michalnand/motoko_ice_dragon_x/README.md

# motoko ice dragon X 
