michalnand/motoko_ice_dragon_x/cut/outline.png

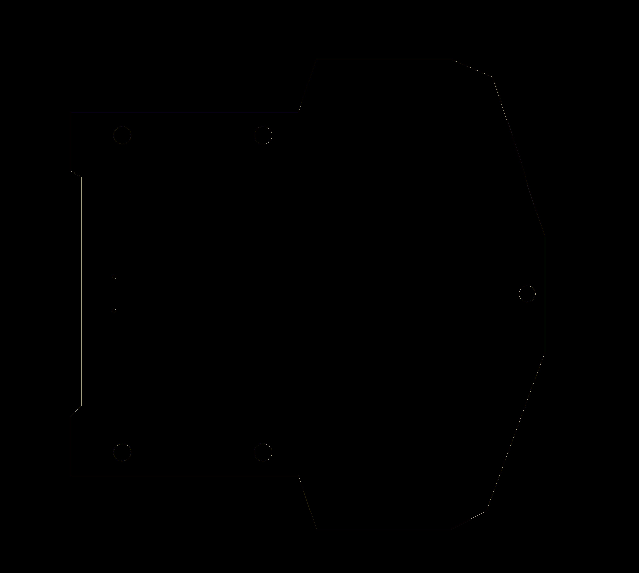
cut/outline.png
