michalnand/motoko_ice_dragon_x/cut/profile.png

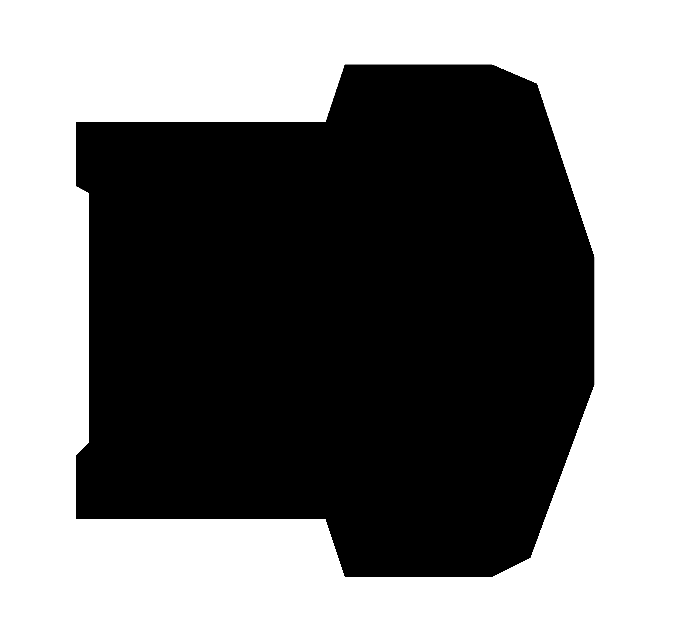
cut/profile.png
