michalnand/motoko_ice_dragon_x/doc/diagrams/control-motor_control.png

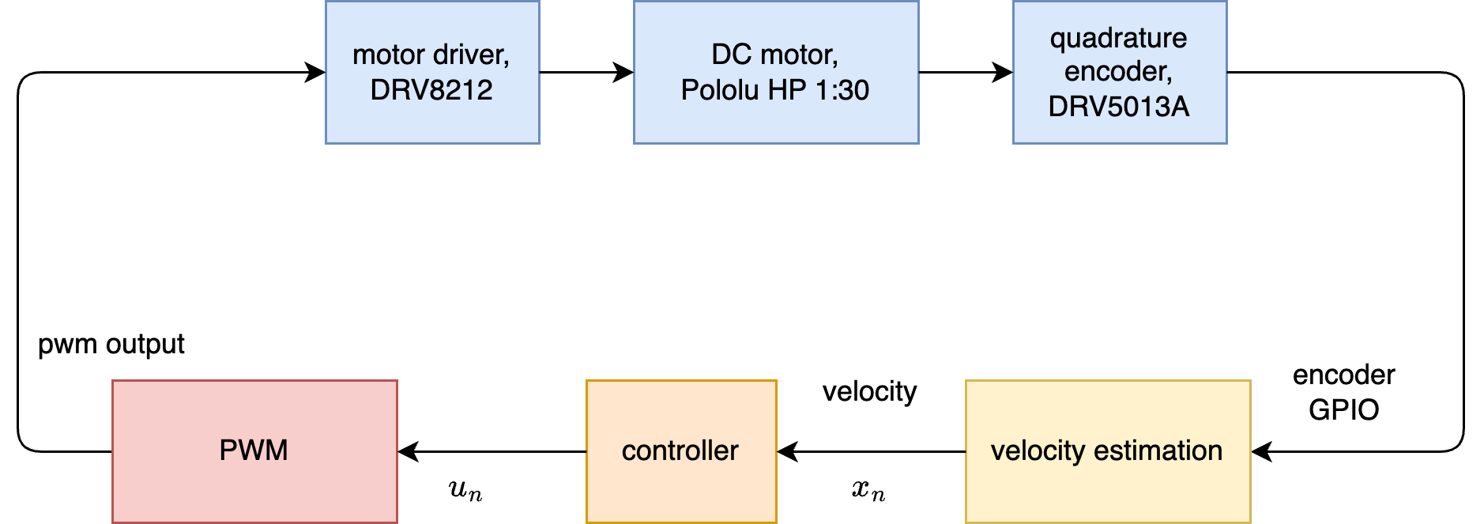
doc/diagrams/control-motor_control.png
