michalnand/motoko_ice_dragon_x/doc/diagrams/controller.png

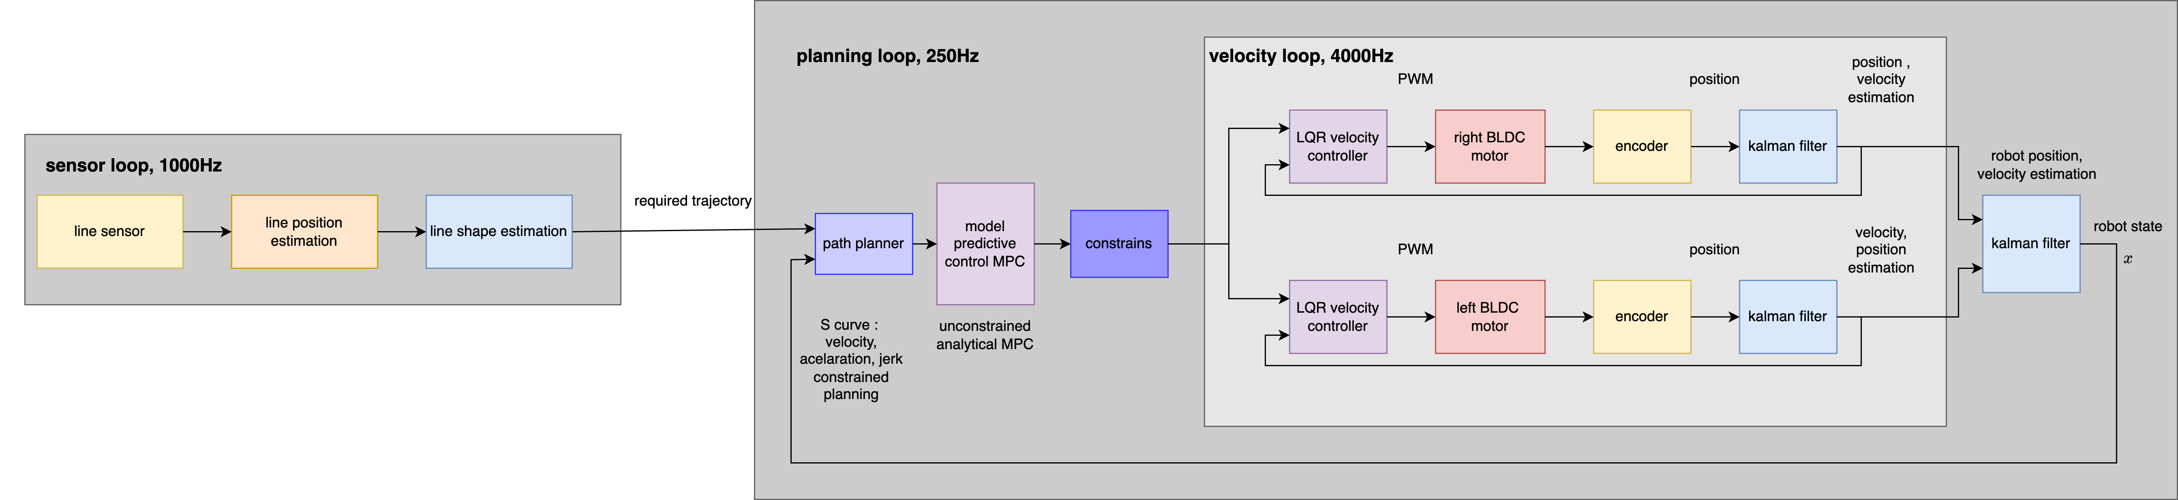
doc/diagrams/controller.png
