michalnand/motoko_ice_dragon_x/doc/images/board_dims_b.png

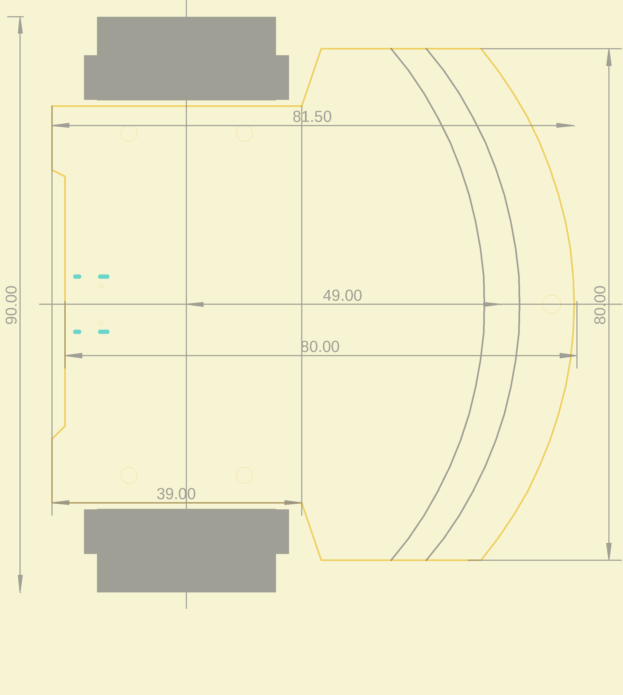
doc/images/board_dims_b.png
