michalnand/motoko_ice_dragon_x/doc/images/board_dims_c.png

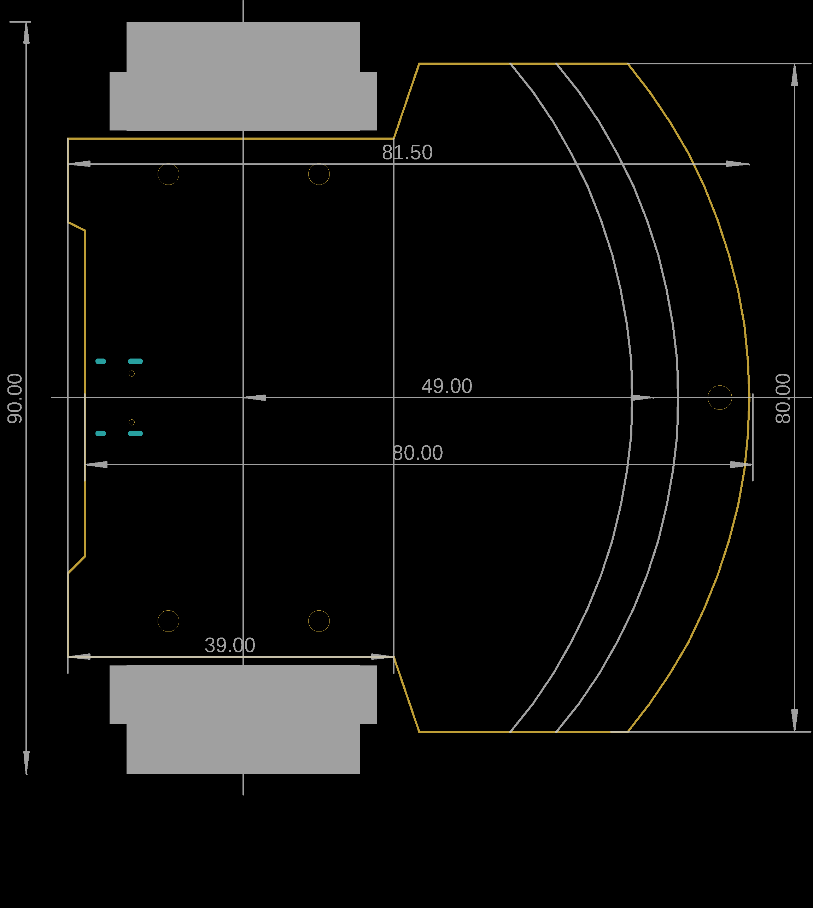
doc/images/board_dims_c.png
