michalnand/motoko_ice_dragon_x/doc/images/box.png

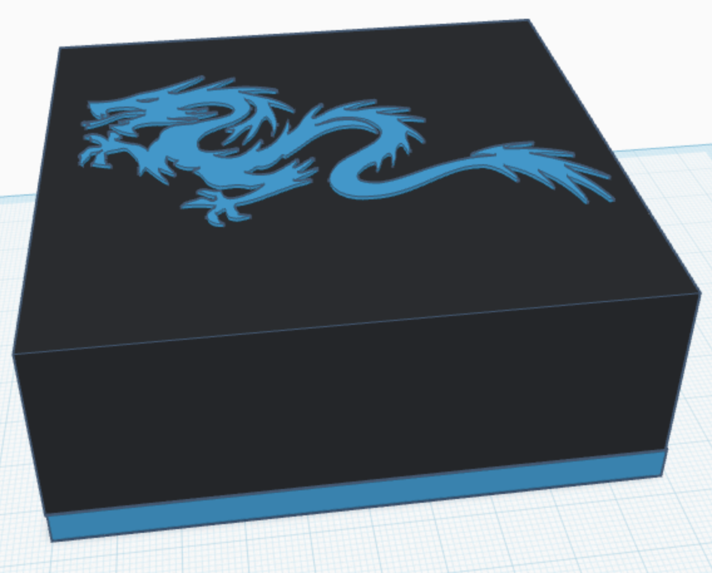
doc/images/box.png
