michalnand/motoko_ice_dragon_x/doc/images/motor.jpeg

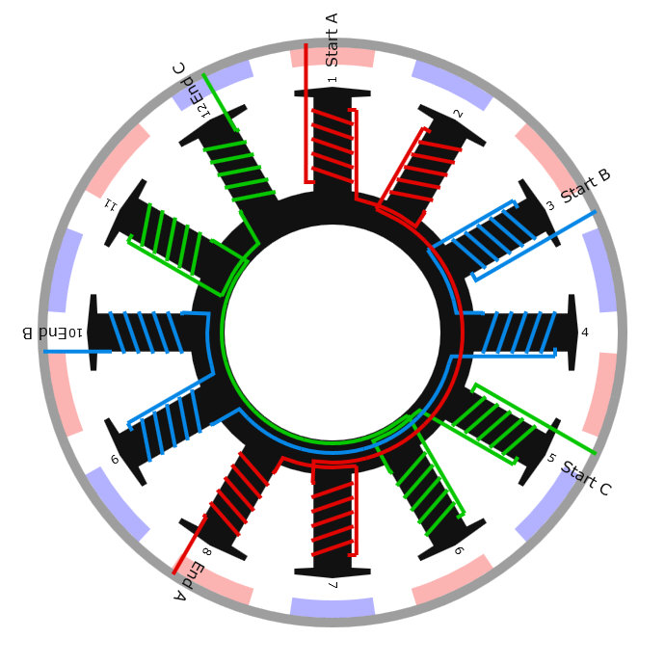
doc/images/motor.jpeg
