michalnand/motoko_ice_dragon_x/doc/images/Screenshot 2024-11-02 at 07.40.02.png

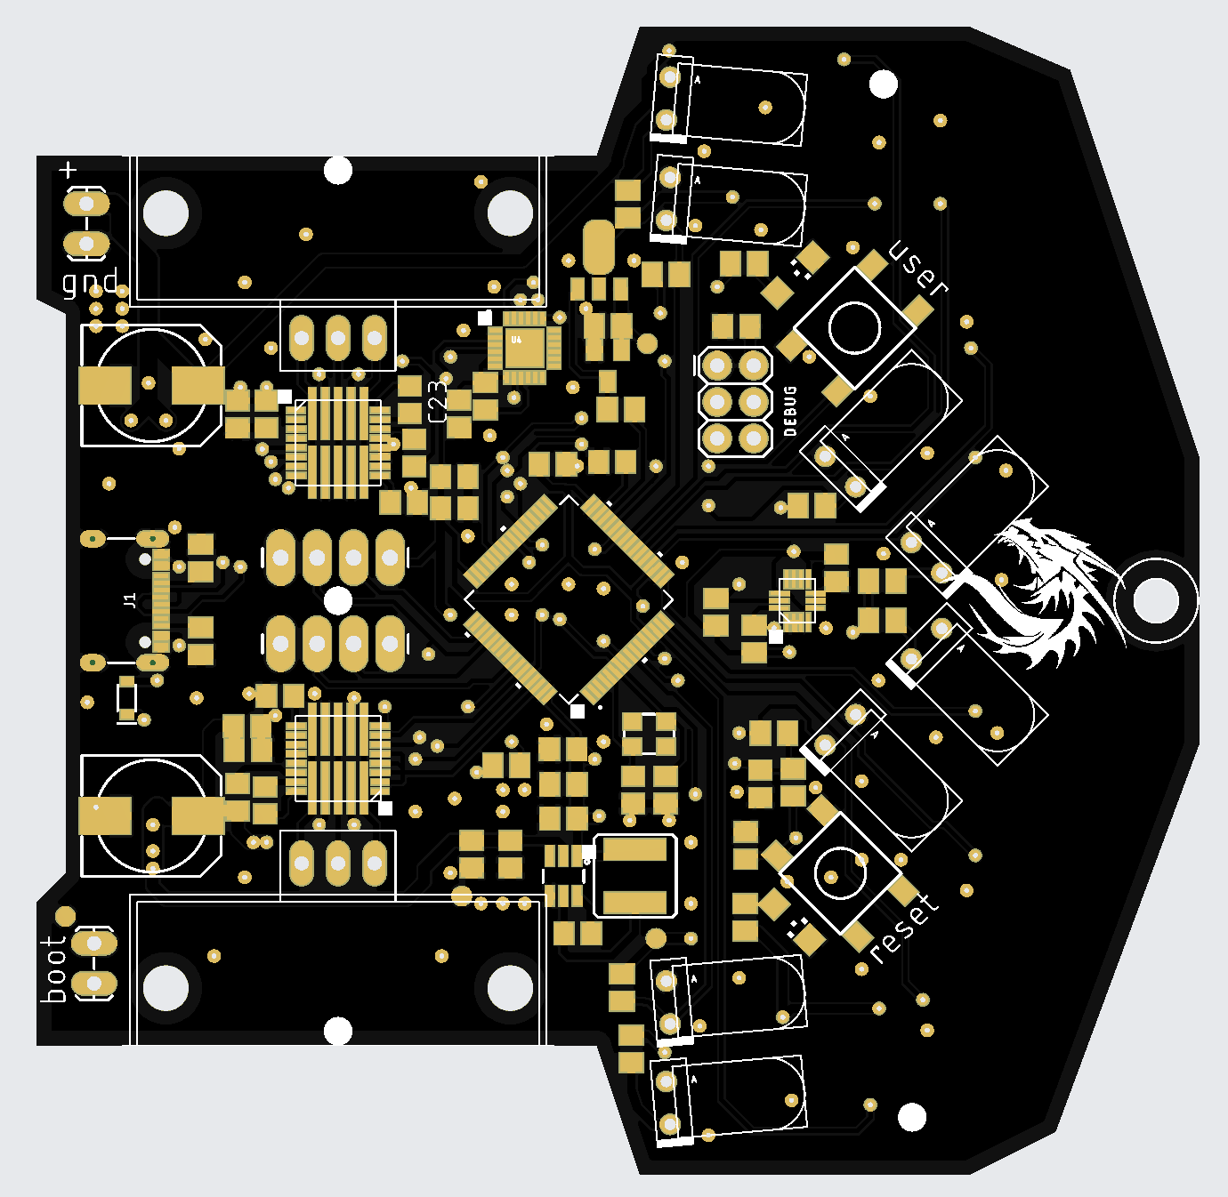
doc/images/Screenshot 2024-11-02 at 07.40.02.png
