michalnand/motoko_ice_dragon_x/simulations/motor_controller/pid_discrete_output.png

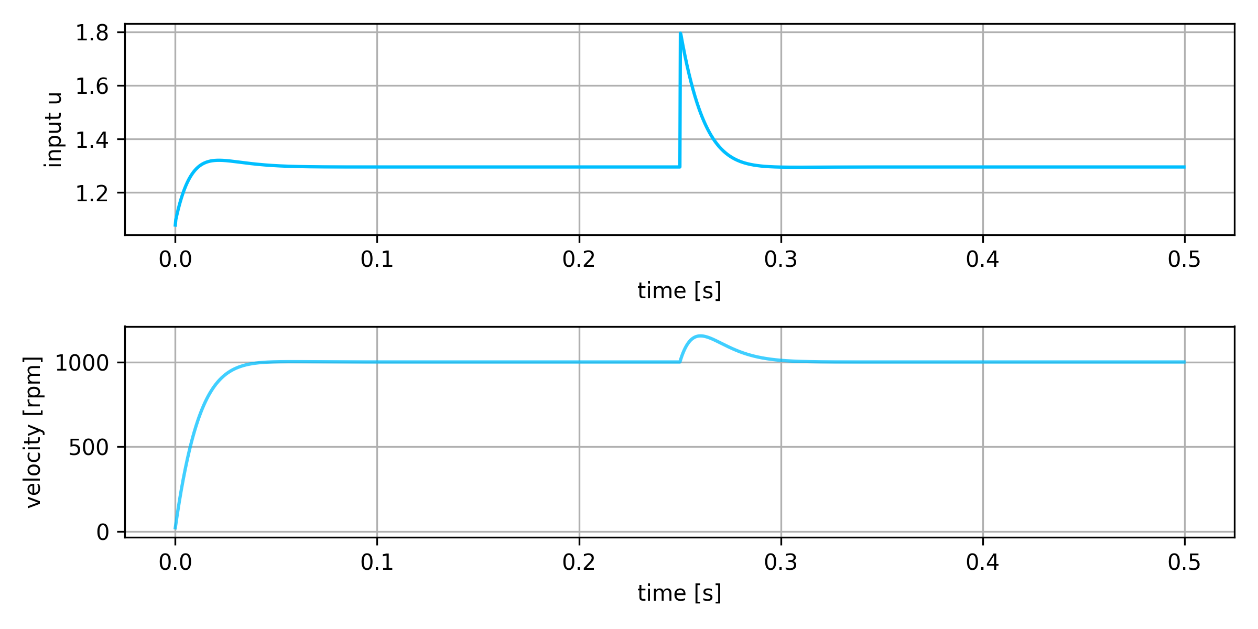
simulations/motor_controller/pid_discrete_output.png
