michalnand/motoko_ice_dragon_x/simulations/position_controller/lqr_controller_output.png

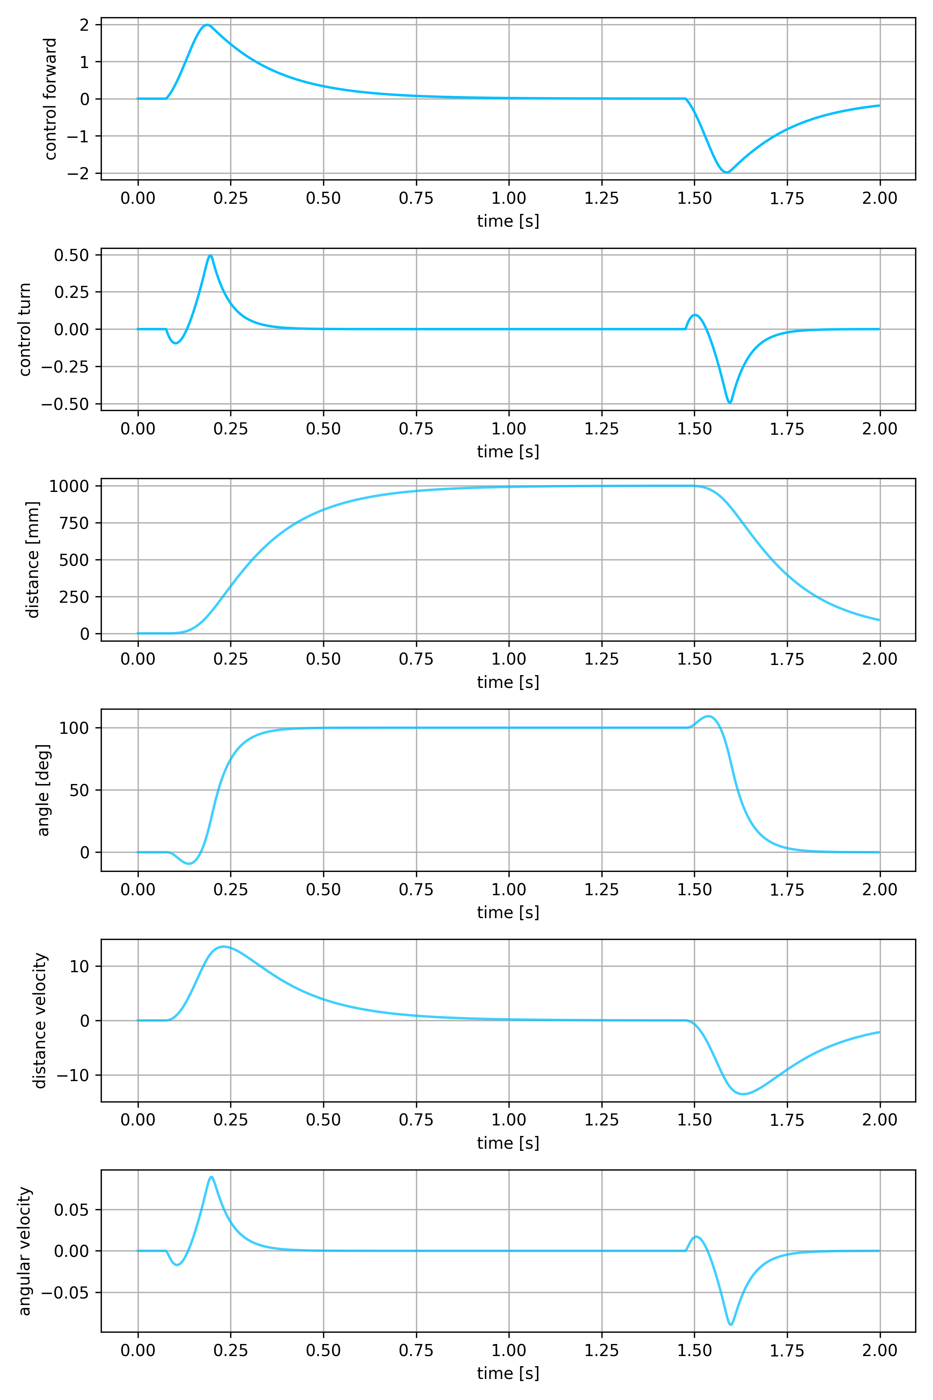
simulations/position_controller/lqr_controller_output.png
