michalnand/motoko_ice_dragon_x/simulations/position_controller/lqri_controller_output.png

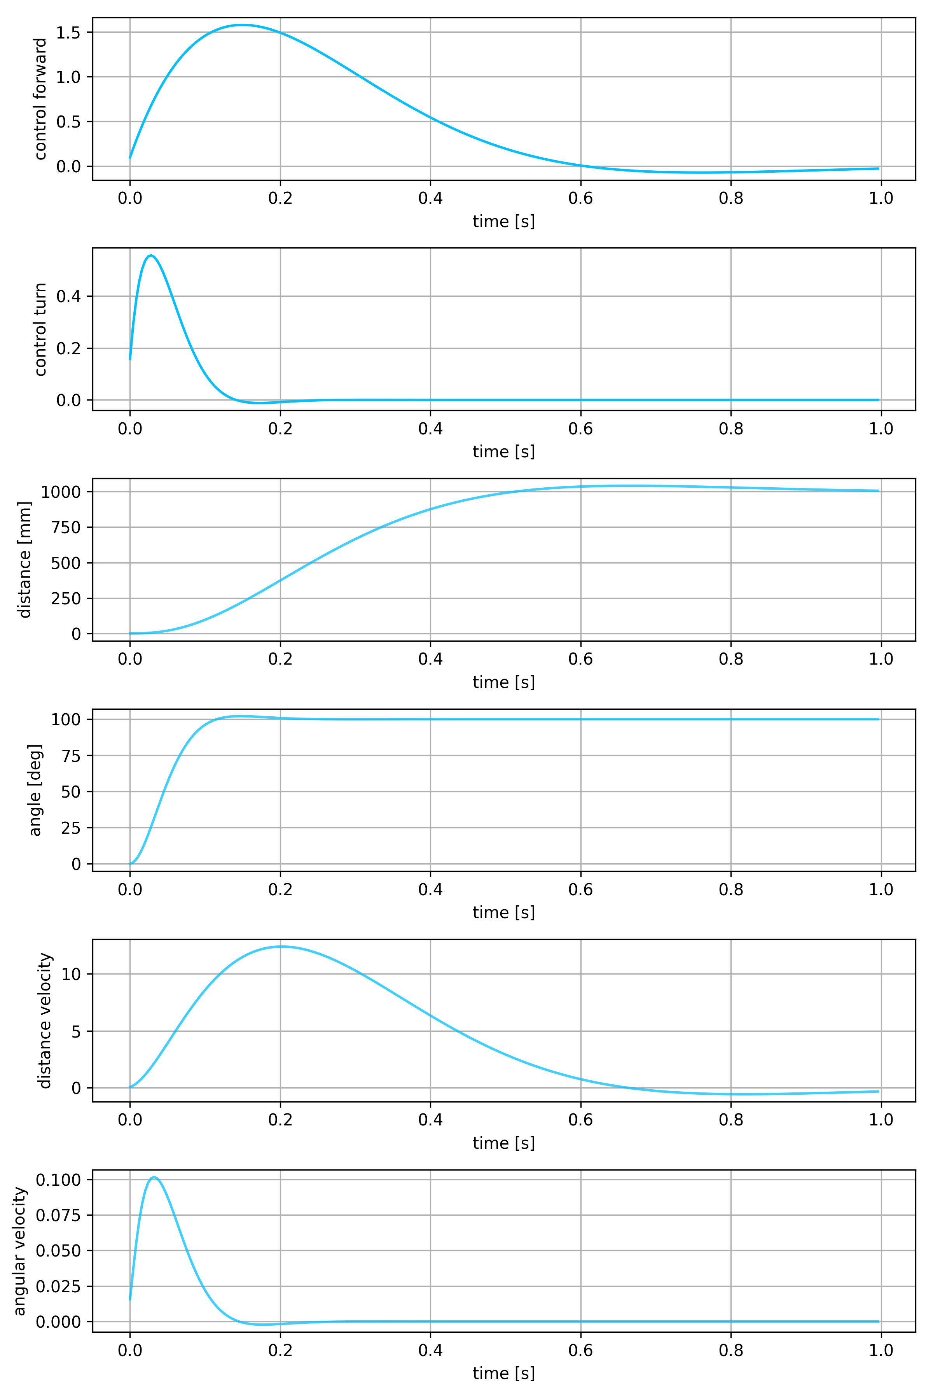
simulations/position_controller/lqri_controller_output.png
