michalnand/motoko_ice_dragon_x/simulations/trajectory_tracking_/lqr_controller_output.png

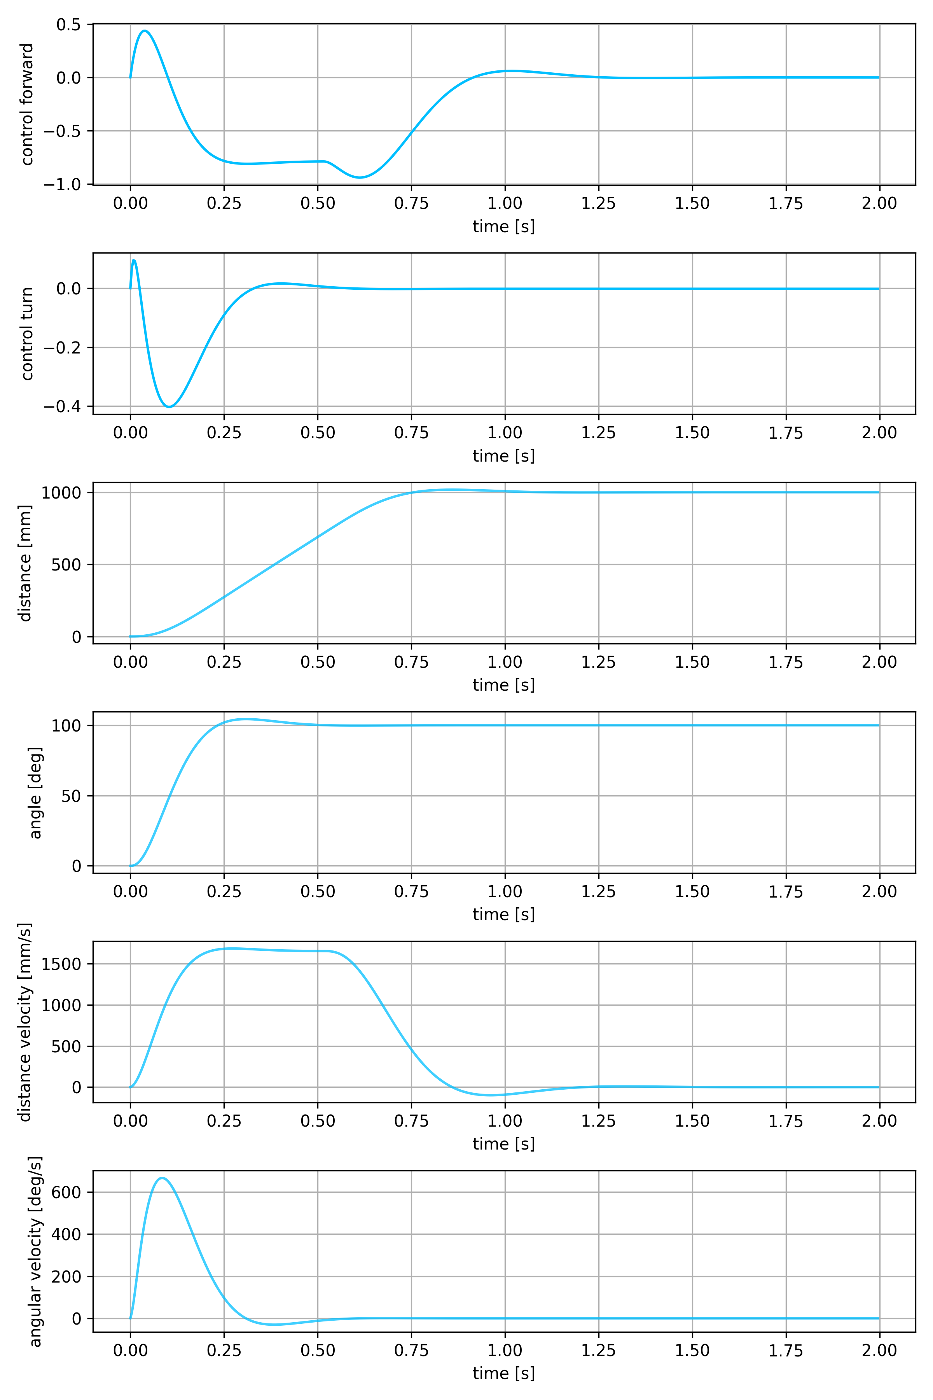
simulations/trajectory_tracking_/lqr_controller_output.png
