michalnand/motoko_ice_dragon_x/doc/diagrams/control-1st_order_identification.png

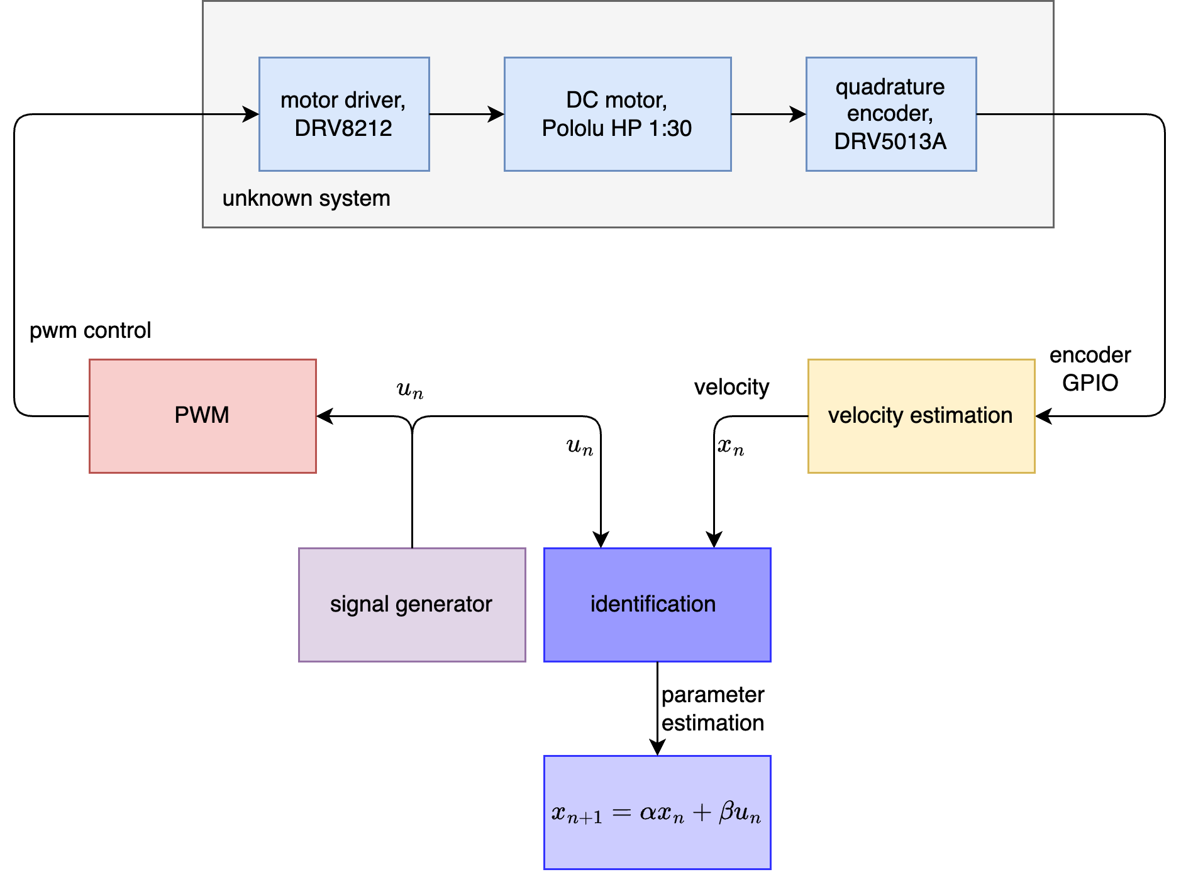
doc/diagrams/control-1st_order_identification.png
