michalnand/motoko_ice_dragon_x/3d_print/box/dragon.stl

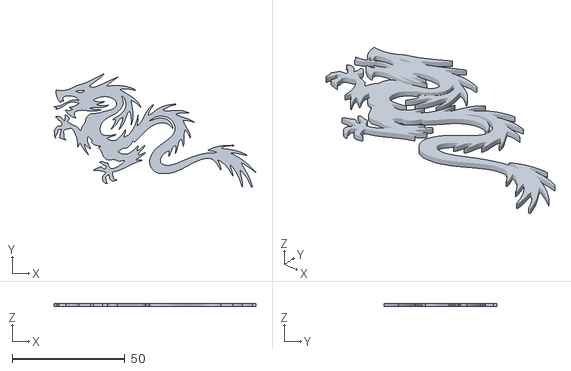
[picture p21: CAD file, 2025-03-23]
3d_print/box/dragon.stl
89.5 x 50.2 x 1.50
