michalnand/motoko_ice_dragon_x/3d_print/brushless_motors/whell_tire_form_b.stl

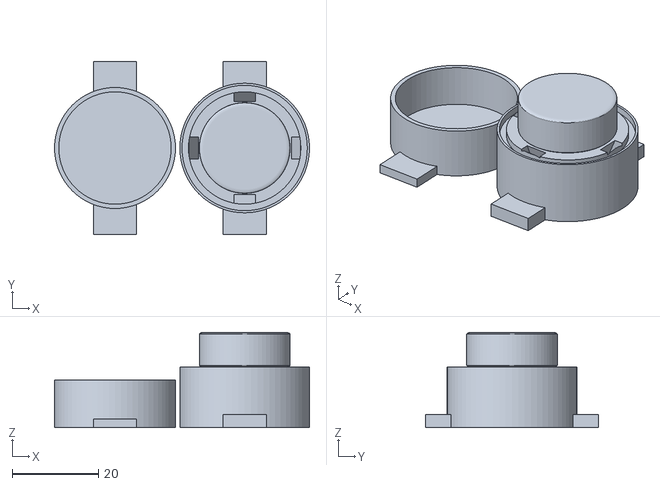
[picture p22: CAD file, 2024-11-26]
3d_print/brushless_motors/whell_tire_form_b.stl
59.0 x 40.0 x 22.0
