michalnand/motoko_ice_dragon_x/3d_print/dc_motors/motoko_ice_dragon_x.stl

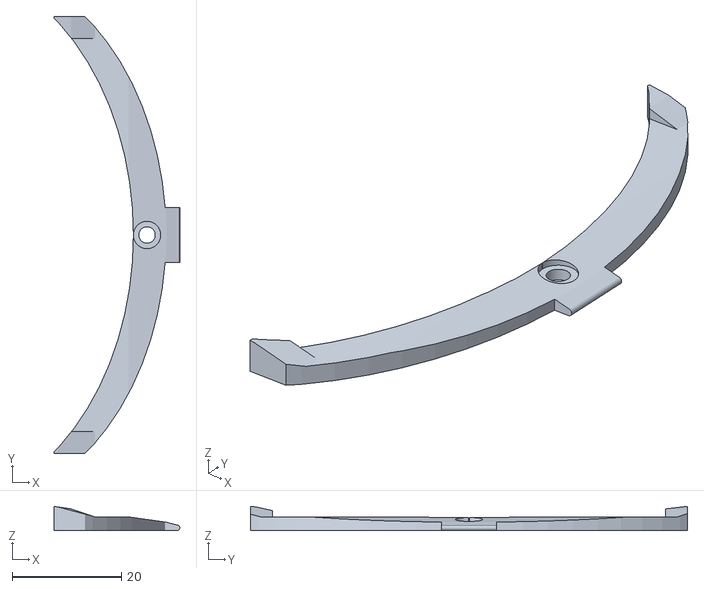
[picture p23: CAD file, 2024-08-08]
3d_print/dc_motors/motoko_ice_dragon_x.stl
23.0 x 80.0 x 4.41
