michalnand/motoko_ice_dragon_x/hardware/bldc_motors/motoko_ice_dragon_x_bldc.dxf

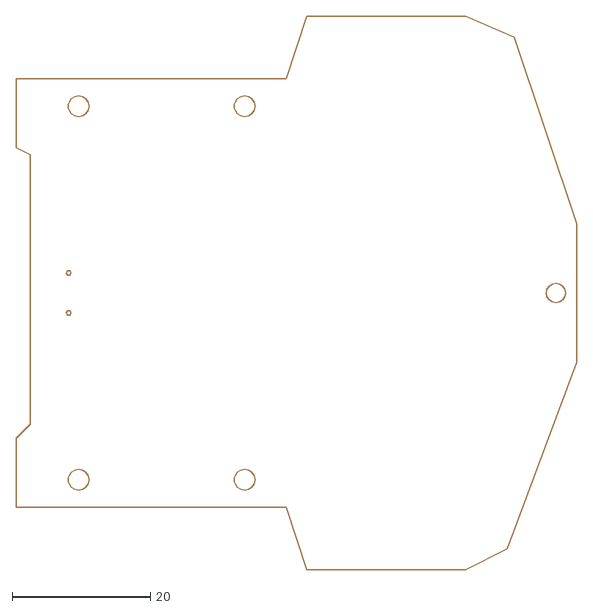
[picture p24: CAD file, 2024-11-22]
hardware/bldc_motors/motoko_ice_dragon_x_bldc.dxf
81.0 x 80.0
