michalnand/motoko_ice_dragon_x/simulations/target_tracking/robot_model/robot.obj

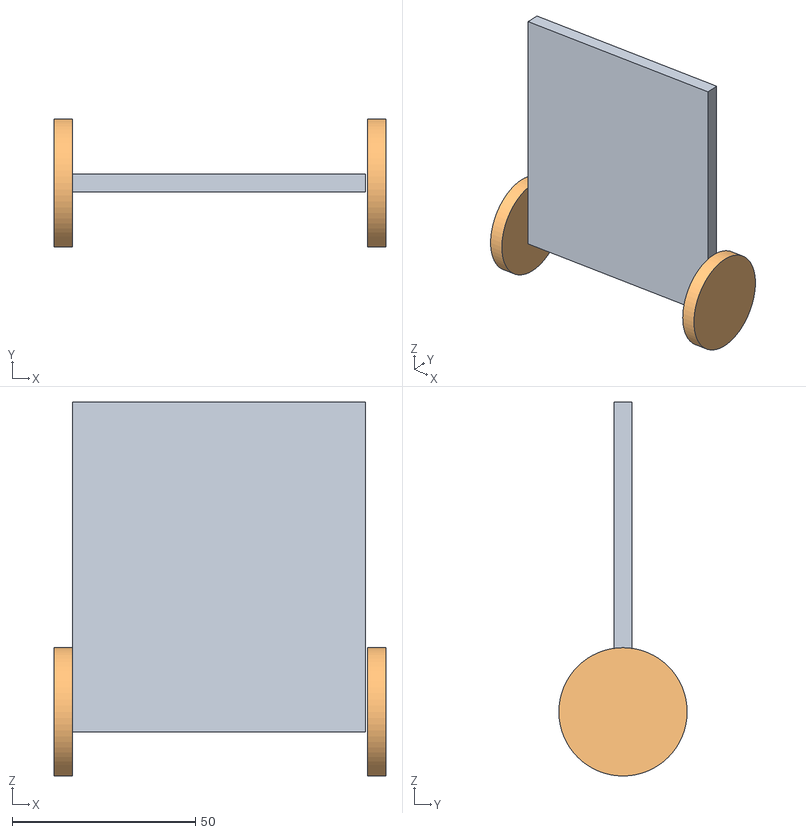
[picture p25: CAD file, 2024-07-23]
simulations/target_tracking/robot_model/robot.obj
90.5 x 35.0 x 102.0
