michalnand/motoko_ice_dragon_x/3d_print/box/robot_box_a.stl

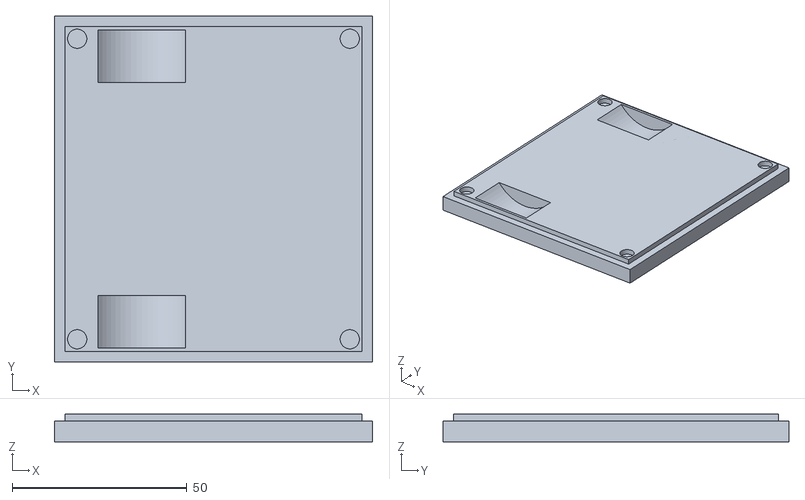
[picture p26: CAD file, 2025-03-23]
3d_print/box/robot_box_a.stl
91.0 x 99.0 x 8.00
