michalnand/motoko_ice_dragon_x/3d_print/brushless_motors/motor_holder_1804.stl

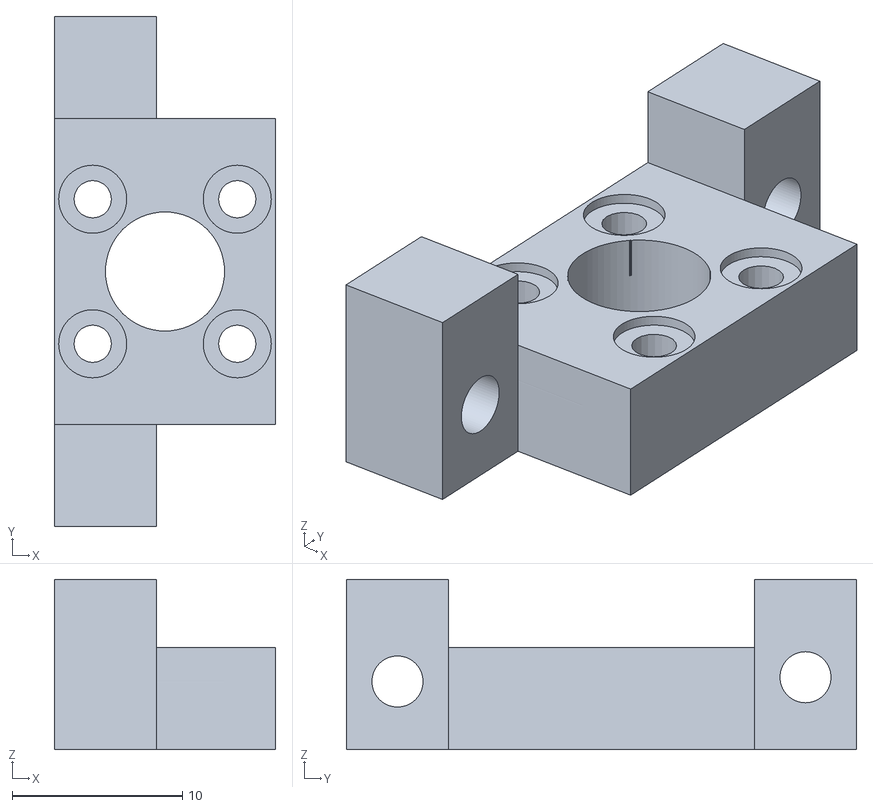
[picture p27: CAD file, 2024-11-22]
3d_print/brushless_motors/motor_holder_1804.stl
13.0 x 30.0 x 10.0
