michalnand/motoko_ice_dragon_x/3d_print/box/robot_box_b.stl

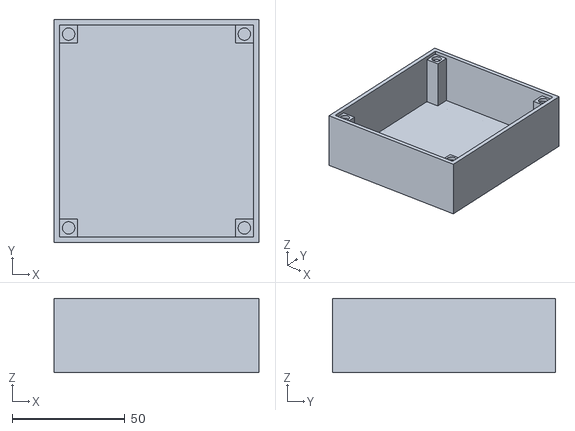
[picture p28: CAD file, 2025-03-23]
3d_print/box/robot_box_b.stl
91.0 x 99.0 x 33.0
