michalnand/motoko_ice_dragon_x/3d_print/brushless_motors/robot_front.stl

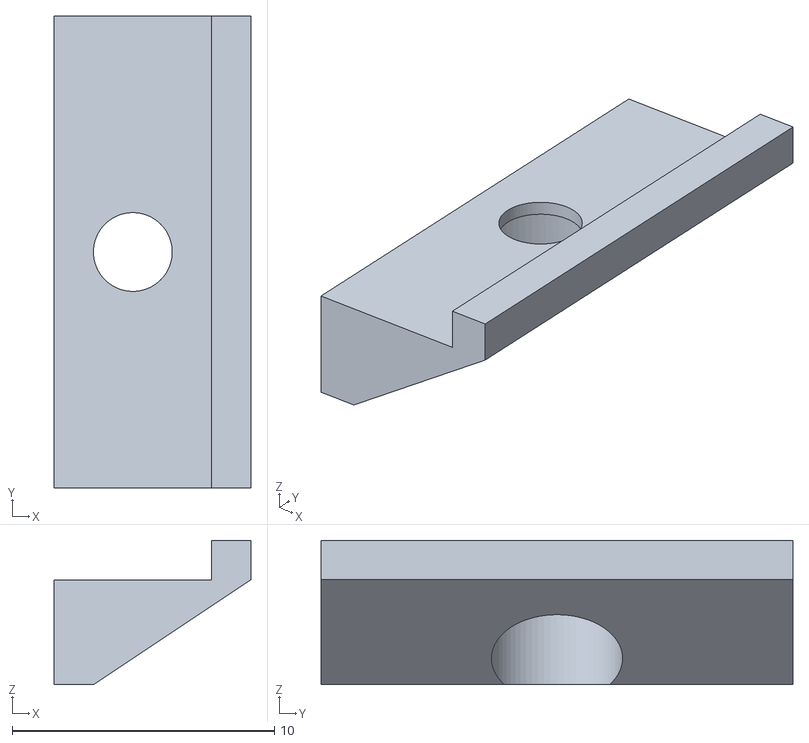
[picture p29: CAD file, 2024-11-22]
3d_print/brushless_motors/robot_front.stl
7.50 x 18.0 x 5.50
