michalnand/motoko_ice_dragon_x/3d_print/brushless_motors/magnet_holder.stl

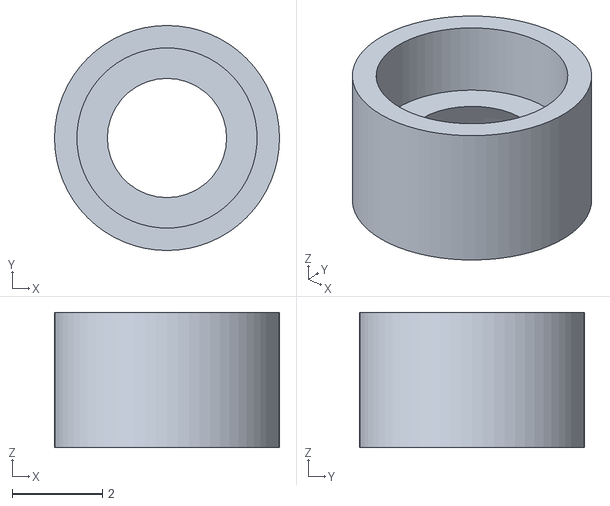
[picture p30: CAD file, 2024-11-22]
3d_print/brushless_motors/magnet_holder.stl
5.00 x 5.00 x 3.00
