michalnand/motoko_ice_dragon_x/hardware/dc_motors copy/motoko_ice_dragon_x_dc.dxf

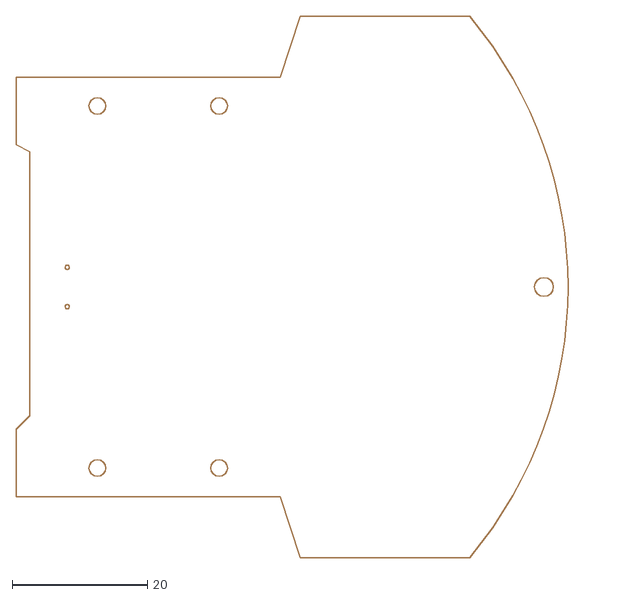
[picture p31: CAD file, 2024-06-19, an earlier design]
hardware/dc_motors copy/motoko_ice_dragon_x_dc.dxf
86.4 x 80.0
