michalnand/motoko_ice_dragon_x/simulations/motor_controller/plots/step_response.png

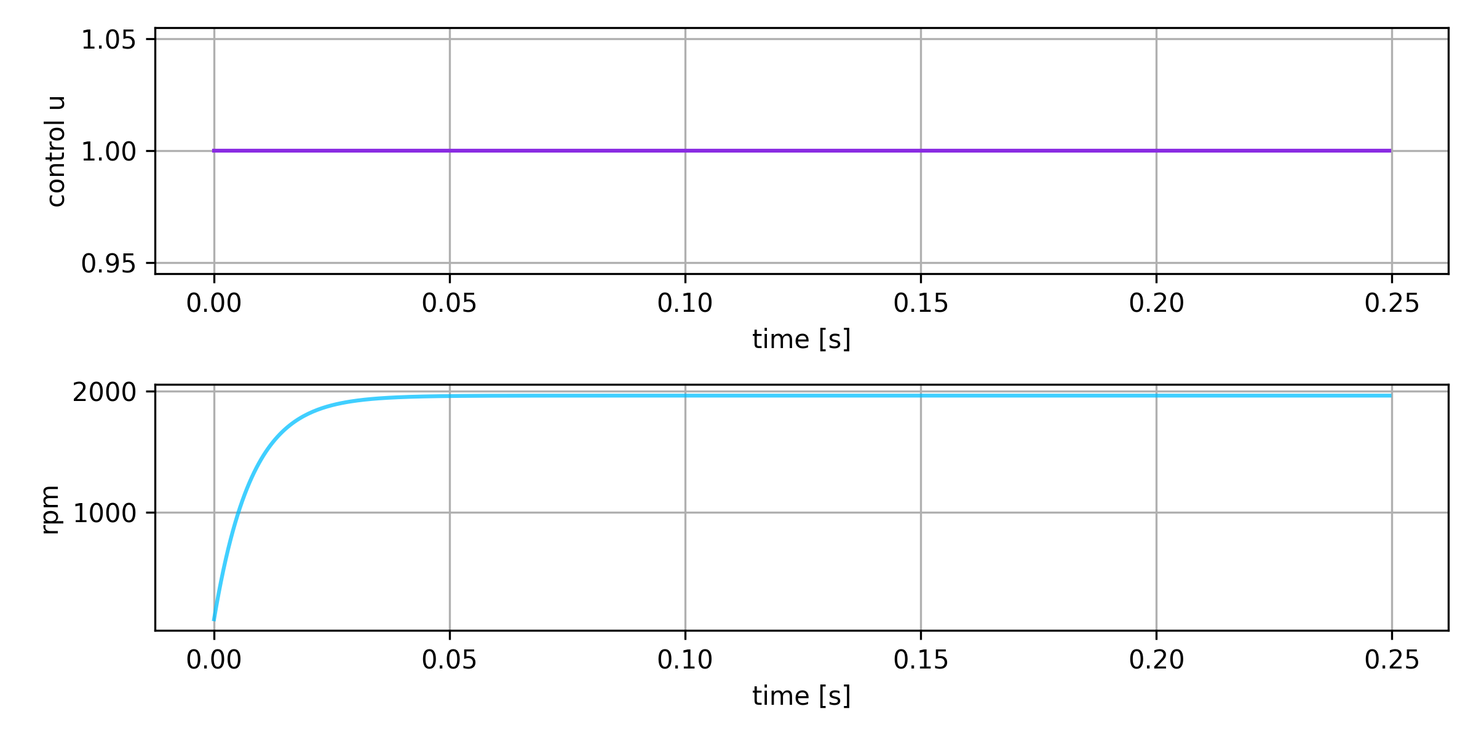
simulations/motor_controller/plots/step_response.png
