michalnand/motoko_ice_dragon_x/simulations/motor_controller/plots/lqg_result.png

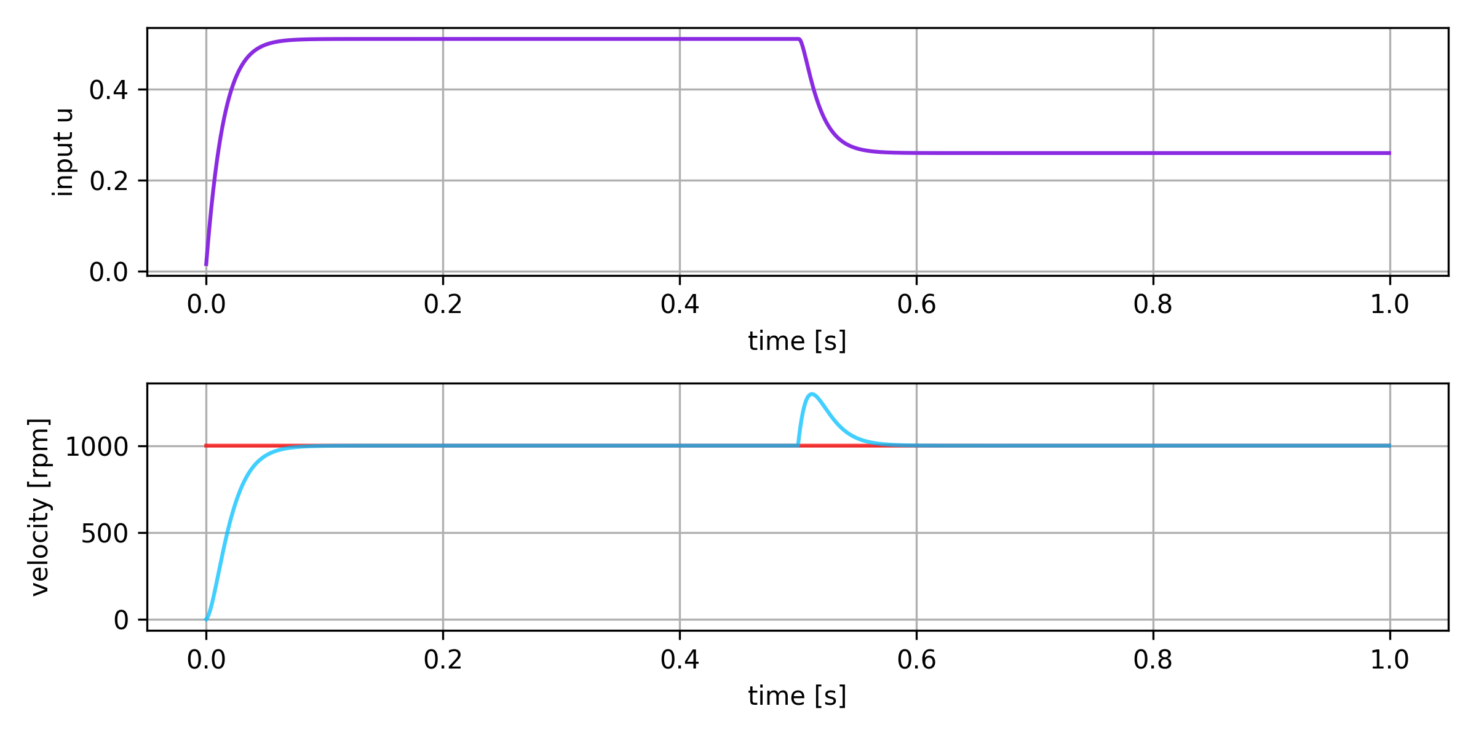
simulations/motor_controller/plots/lqg_result.png
