michalnand/motoko_ice_dragon_x/hardware/dc_motors/motoko_ice_dragon_x_dc.brd

## EAGLE design hardware/dc_motors/motoko_ice_dragon_x_dc.brd (2025-11-20)

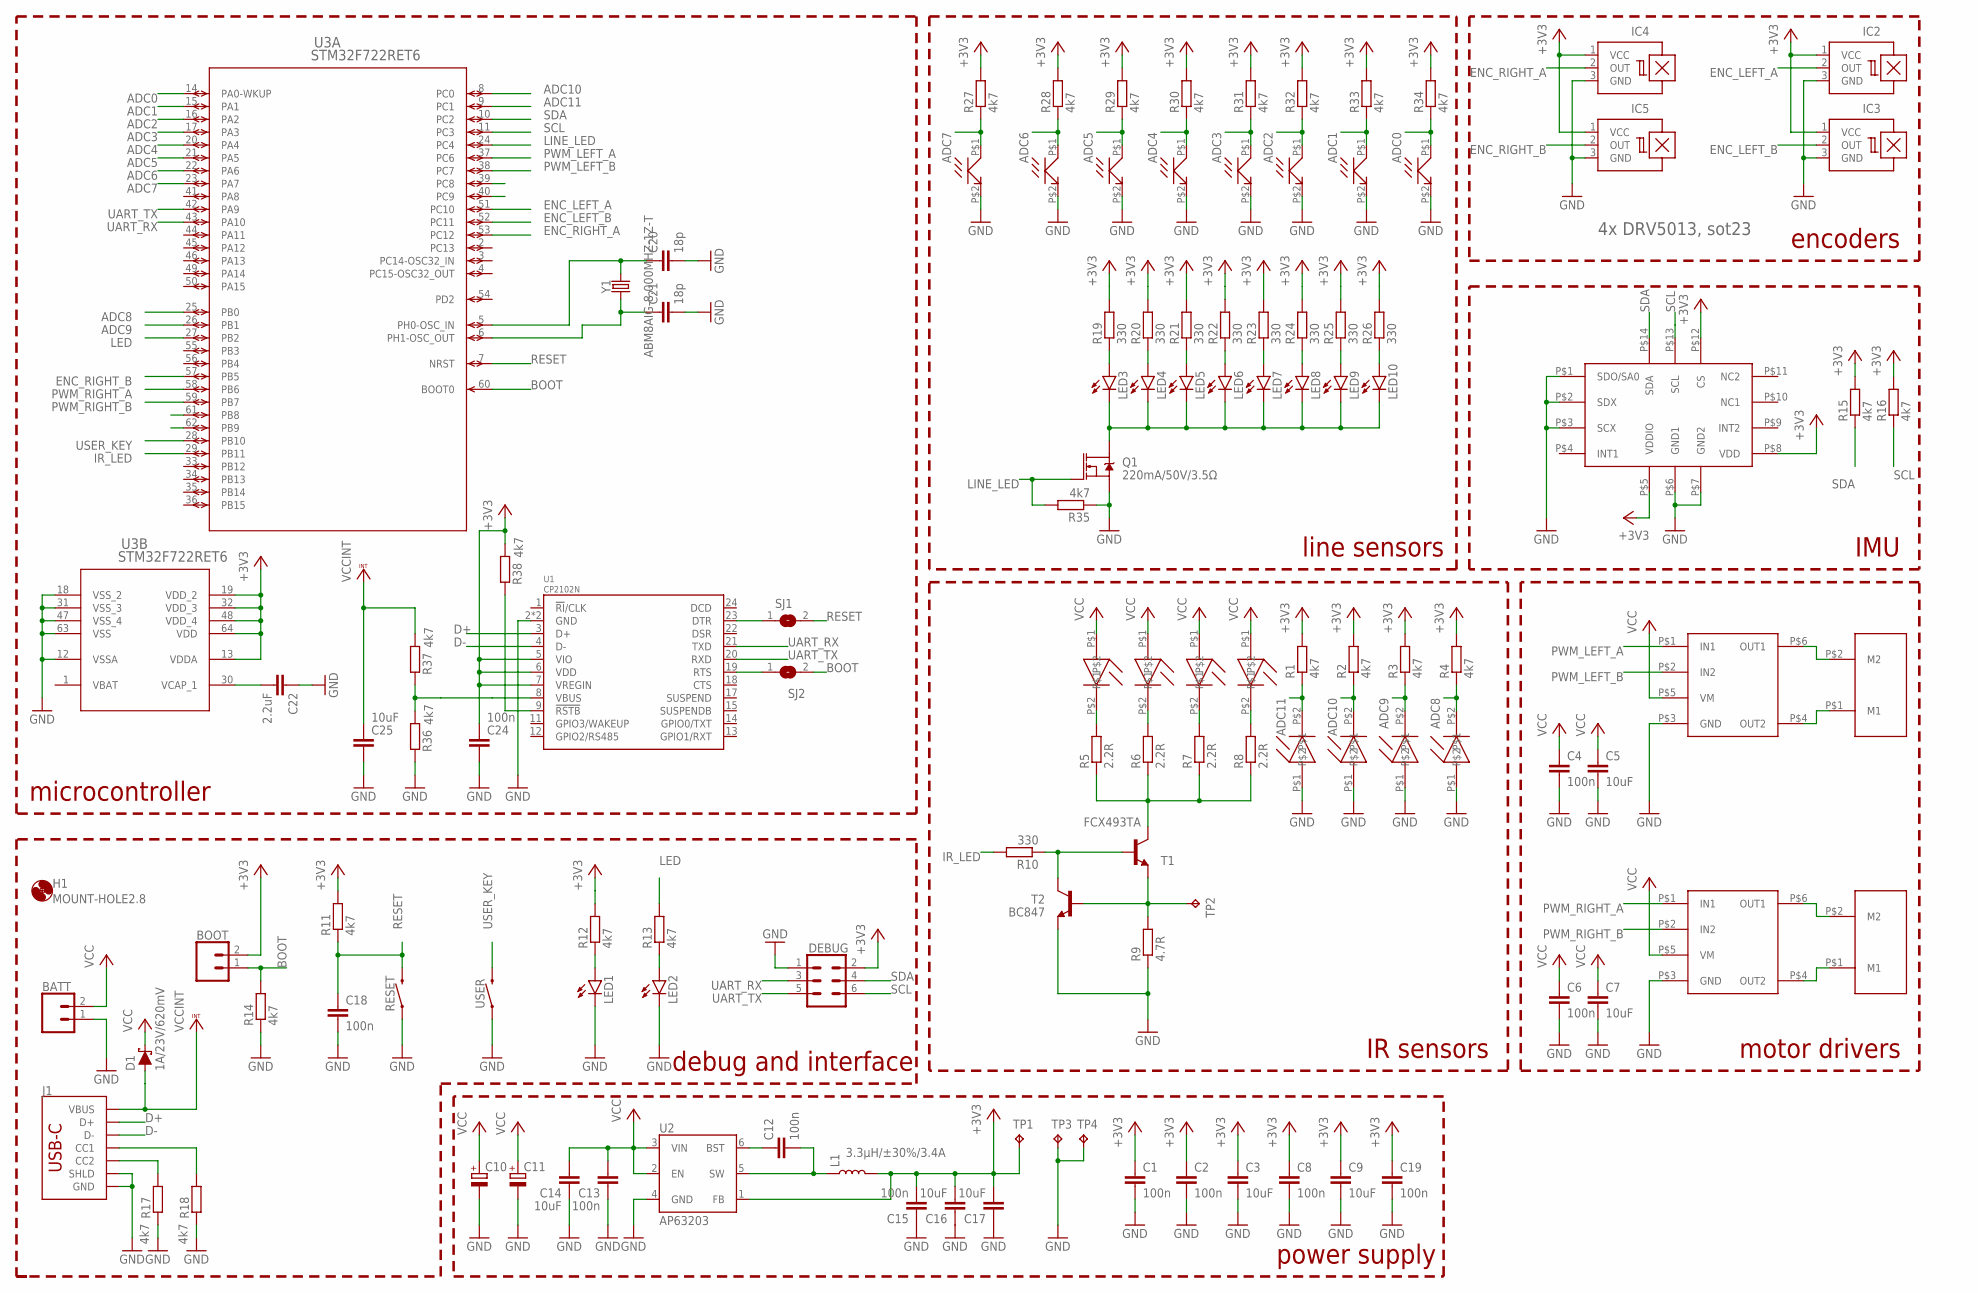
[picture p34: schematic motoko_ice_dragon_x_dc.sch]

Parts:
BATT: CONN_02LOCK_LONGPADS; 1X02_LOCK_LONGPADS
BOOT: CONN_02LOCK_LONGPADS; 1X02_LOCK_LONGPADS
C1, C2, C4, C6, C8, C12, C13, C15, C18, C19, C24: 100n; C0805
C3, C5, C7, C9, C14, C16, C17, C25: 10uF; C0805
C10, C11: CPOL-EU140CLH-0810; 140CLH-0810
C20, C21: 18p; C0805
C22: 2.2uF; C0805
D1: 1A/23V/620mV; SOD-323
DEBUG: FEMALE 2x3; 2X3
H1: MOUNT-HOLE2.8; 2,8
IC2, IC3, IC4, IC5: A1202LH; SOT23-W
J1: 640-USB4105-GF-A-120, man. GCT; USB-C-16P-2LAYER-PADS
L1: 3.3µH/±30%/3.4A; CR54
LED1, LED2, LED3, LED4, LED5, LED6, LED7, LED8, LED9, LED10: LEDCHIPLED_1206; CHIPLED_1206
Q1: 220mA/50V/3.5Ω; SOT23-3
R1, R2, R3, R4, R11, R12, R13, R14, R15, R16, R17, R18, R27, R28, R29, R30, R31, R32, R33, R34, R35, R36, R37, R38: 4k7; M0805
R5, R6, R7, R8: 2.2R; M0805
R9: 4.7R; M0805
R10, R19, R20, R21, R22, R23, R24, R25, R26: 330; M0805
RESET: MOMENTARY-SWITCH-SPST-SMD-6.2MM-TALL; TACTILE_SWITCH_SMD_6.2MM_TALL
SJ1, SJ2: SJ
T1: FCX493TA; SOT89-BCE
T2: BC847; SOT23
TP1, TP2, TP3, TP4: TPB1,27; B1,27
U1: CP2102N; QFN24
U2: AP63203; SOT23-6
U3: STM32F722RET6; LQFP64-10X10MM
U$1, U$3: DRV8212; SOT_0.6MM
U$2, U$15, U$16, U$17, U$18, U$19, U$20, U$21: SFH3710; SFH710
U$4, U$5: POLOLU_MICRO_METAL_GEAR_MOTOR
U$6: LSM6DSM; LGA14L
U$7, U$8, U$9, U$10, U$11, U$12, U$13, U$14: LED_5MM_AXIAL
USER: MOMENTARY-SWITCH-SPST-SMD-6.2MM-TALL; TACTILE_SWITCH_SMD_6.2MM_TALL
Y1: ABM8AIG-8.000MHZ-1Z-T; CRYSTAL-SMD-3.2X2.5MM

Connections:
+3V3: BOOT.2, C1.1, C2.1, C3.1, C8.1, C9.1, C15.2, C16.2, C17.2, C19.1, C24.1, DEBUG.2, IC2.1 (VCC), IC3.1 (VCC), IC4.1 (VCC), IC5.1 (VCC), L1.P$2 (2), R1.2, R2.2, R3.2, R4.2, R11.2, R12.2, R15.2, R16.2, R19.2, R20.2, R21.2, R22.2, R23.2, R24.2, R25.2, R26.2, R27.2, R28.2, R29.2, R30.2, R31.2, R32.2, R33.2, R34.2, R38.1, TP1.TP, U1.5 (VIO), U1.6 (VDD), U1.7 (VREGIN), U2.1 (FB), U3.13 (VDDA), U3.19 (VDD_2), U3.32 (VDD_3), U3.48 (VDD_4), U3.64 (VDD), U$6.P$5 (VDDIO), U$6.P$8 (VDD), U$6.P$12 (CS)
ADC0: R34.1, U3.14 (PA0-WKUP), U$21.P$1 (C)
ADC1: R33.1, U3.15 (PA1), U$20.P$1 (C)
ADC2: R32.1, U3.16 (PA2), U$19.P$1 (C)
ADC3: R31.1, U3.17 (PA3), U$18.P$1 (C)
ADC4: R30.1, U3.20 (PA4), U$17.P$1 (C)
ADC5: R29.1, U3.21 (PA5), U$16.P$1 (C)
ADC6: R28.1, U3.22 (PA6), U$15.P$1 (C)
ADC7: R27.1, U3.23 (PA7), U$2.P$1 (C)
ADC8: R4.1, U3.25 (PB0), U$7.P$2
ADC9: R3.1, U3.26 (PB1), U$11.P$2
ADC10: R2.1, U3.8 (PC0), U$14.P$2
ADC11: R1.1, U3.9 (PC1), U$9.P$2
BOOT: BOOT.1, R14.2, SJ2.2, U3.60 (BOOT0)
D+: J1.A6 (D+), J1.B6 (D+), U1.3 (D+)
D-: J1.A7 (D-), J1.B7 (D-), U1.4 (D-)
ENC_LEFT_A: IC2.2 (OUT), U3.51 (PC10)
ENC_LEFT_B: IC3.2 (OUT), U3.52 (PC11)
ENC_RIGHT_A: IC4.2 (OUT), U3.53 (PC12)
ENC_RIGHT_B: IC5.2 (OUT), U3.57 (PB5)
GND: BATT.1, C1.2, C2.2, C3.2, C4.2, C5.2, C6.2, C7.2, C8.2, C9.2, C10.-, C11.-, C13.1, C14.1, C15.1, C16.1, C17.1, C18.2, C19.2, C20.2, C21.2, C22.1, C24.2, C25.2, DEBUG.1, IC2.3 (GND), IC3.3 (GND), IC4.3 (GND), IC5.3 (GND), J1.GND, J1.GND2 (GND), J1.SHLD1 (SHLD), J1.SHLD2 (SHLD), J1.SHLD3 (SHLD), J1.SHLD4 (SHLD), LED1.C, LED2.C, Q1.2 (S), R9.1, R14.1, R17.1, R18.1, R35.1, R36.2, RESET.A2 (1), T2.2 (E), TP3.TP, TP4.TP, U1.2 (GND), U1.PAD (GND), U2.4 (GND), U3.12 (VSSA), U3.18 (VSS_2), U3.31 (VSS_3), U3.47 (VSS_4), U3.63 (VSS), U$1.P$3 (GND), U$2.P$2 (E), U$3.P$3 (GND), U$6.P$1 (SDO/SA0), U$6.P$2 (SDX), U$6.P$3 (SCX), U$6.P$6 (GND1), U$6.P$7 (GND2), U$7.P$1, U$9.P$1, U$11.P$1, U$14.P$1, U$15.P$2 (E), U$16.P$2 (E), U$17.P$2 (E), U$18.P$2 (E), U$19.P$2 (E), U$20.P$2 (E), U$21.P$2 (E), USER.A2 (1)
IR_LED: R10.2, U3.29 (PB11)
LED: R13.2, U3.27 (PB2)
LINE_LED: Q1.1 (G), R35.2, U3.24 (PC4)
unnamed: U$1.P$6 (OUT1), U$4.P$2 (M2)
unnamed: U$1.P$4 (OUT2), U$4.P$1 (M1)
unnamed: U$3.P$6 (OUT1), U$5.P$2 (M2)
unnamed: U$3.P$4 (OUT2), U$5.P$1 (M1)
unnamed: R5.2, U$10.P$2
unnamed: R6.2, U$13.P$2
unnamed: R7.2, U$12.P$2
unnamed: R8.2, U$8.P$2
unnamed: SJ2.1, U1.19 (RTS)
unnamed: R9.2, T1.E, T2.1 (B), TP2.TP
unnamed: J1.B5 (CC2), R17.2
unnamed: C12.1, U2.6 (BST)
unnamed: C12.2, L1.P$1 (1), U2.5 (SW)
unnamed: R10.1, T1.B, T2.3 (C)
unnamed: R5.1, R6.1, R7.1, R8.1, T1.C
unnamed: LED1.A, R12.1
unnamed: LED2.A, R13.1
unnamed: J1.A5 (CC1), R18.2
unnamed: C20.1, U3.5 (PH0-OSC_IN), Y1.3 (2)
unnamed: C21.1, U3.6 (PH1-OSC_OUT), Y1.1
unnamed: LED3.A, R19.1
unnamed: LED4.A, R20.1
unnamed: C22.2, U3.30 (VCAP_1)
unnamed: LED5.A, R21.1
unnamed: LED6.A, R22.1
unnamed: LED7.A, R23.1
unnamed: LED8.A, R24.1
unnamed: LED9.A, R25.1
unnamed: LED10.A, R26.1
unnamed: LED3.C, LED4.C, LED5.C, LED6.C, LED7.C, LED8.C, LED9.C, LED10.C, Q1.3 (D)
unnamed: SJ1.1, U1.23 (DTR)
unnamed: R38.2, U1.9 (!RSTB)
unnamed: R36.1, R37.2, U1.8 (VBUS)
PWM_LEFT_A: U3.37 (PC6), U$1.P$1 (IN1)
PWM_LEFT_B: U3.38 (PC7), U$1.P$2 (IN2)
PWM_RIGHT_A: U3.58 (PB6), U$3.P$1 (IN1)
PWM_RIGHT_B: U3.59 (PB7), U$3.P$2 (IN2)
RESET: C18.1, R11.1, RESET.B2 (2), SJ1.2, U3.7 (NRST)
SCL: DEBUG.6, R16.1, U3.11 (PC3), U$6.P$13 (SCL)
SDA: DEBUG.4, R15.1, U3.10 (PC2), U$6.P$14 (SDA)
UART_RX: DEBUG.3, U1.21 (TXD), U3.43 (PA10)
UART_TX: DEBUG.5, U1.20 (RXD), U3.42 (PA9)
USER_KEY: U3.28 (PB10), USER.B2 (2)
VBAT: U3.1 (VBAT)
VCC: BATT.2, C4.1, C5.1, C6.1, C7.1, C10.+, C11.+, C13.2, C14.2, D1.C, U2.2 (EN), U2.3 (VIN), U$1.P$5 (VM), U$3.P$5 (VM), U$8.P$1, U$10.P$1, U$12.P$1, U$13.P$1
VCCINT: C25.1, D1.A, J1.VBUS1 (VBUS), J1.VBUS2 (VBUS), R37.1

Notes on the sheet:
4x DRV5013, sot23
line sensors
encoders
IMU
motor drivers
IR sensors
power supply
debug and interface
microcontroller

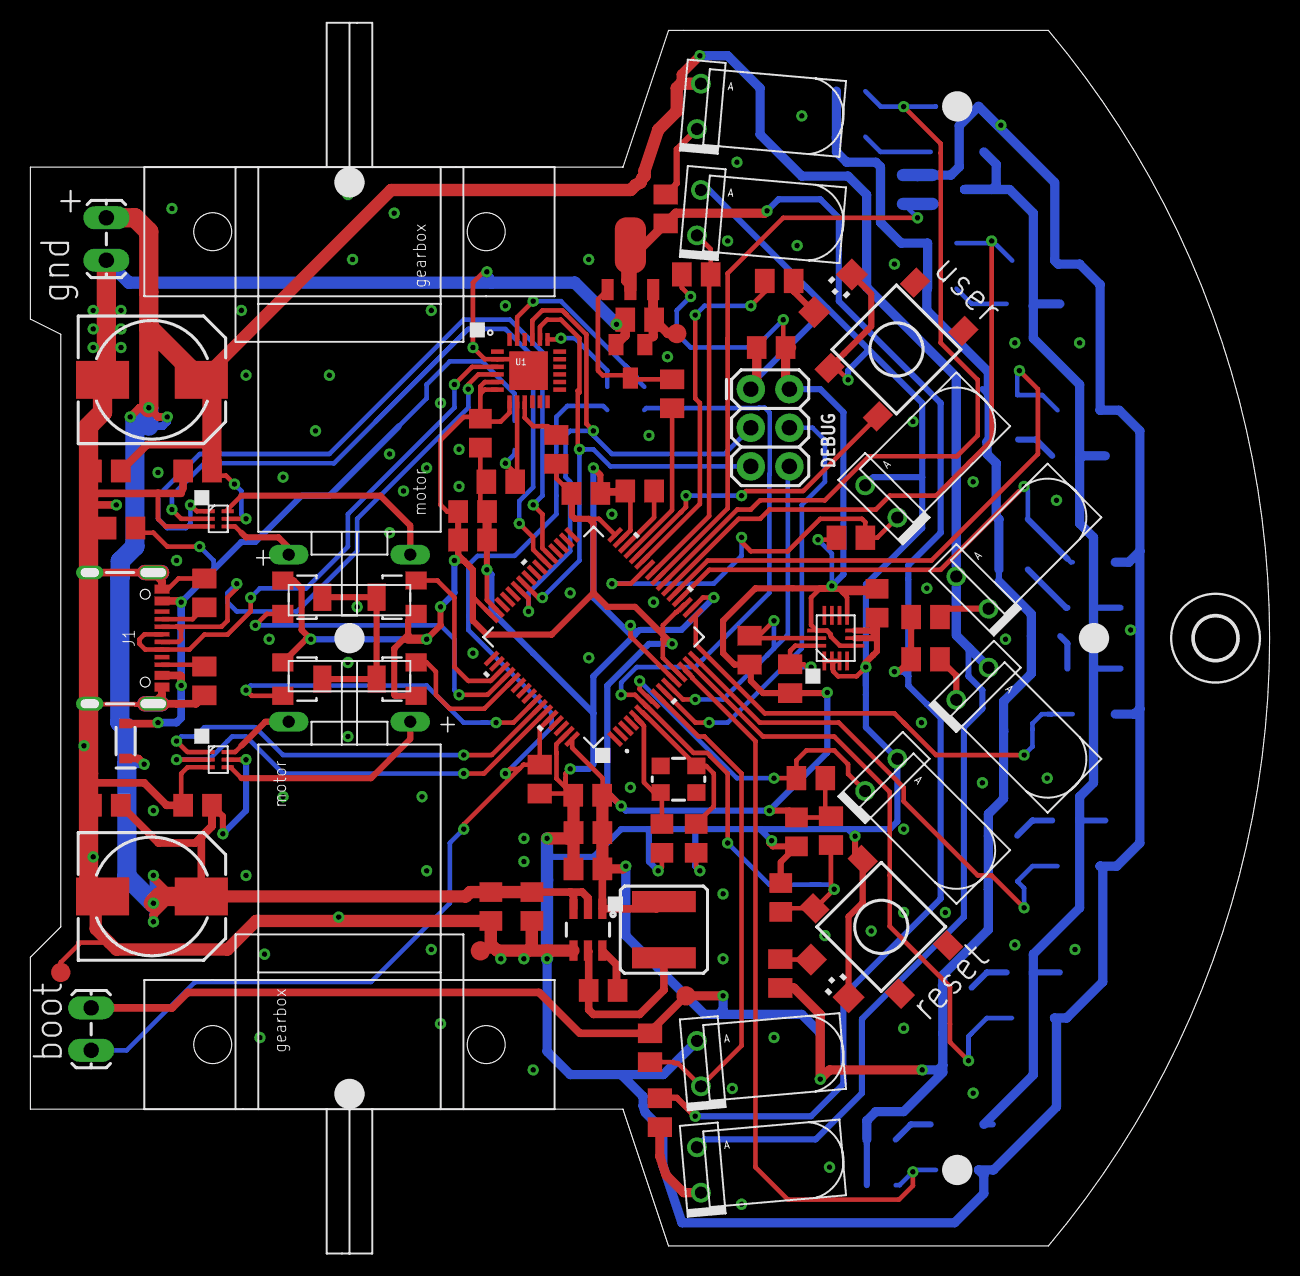
[picture p35: board motoko_ice_dragon_x_dc.brd from above]

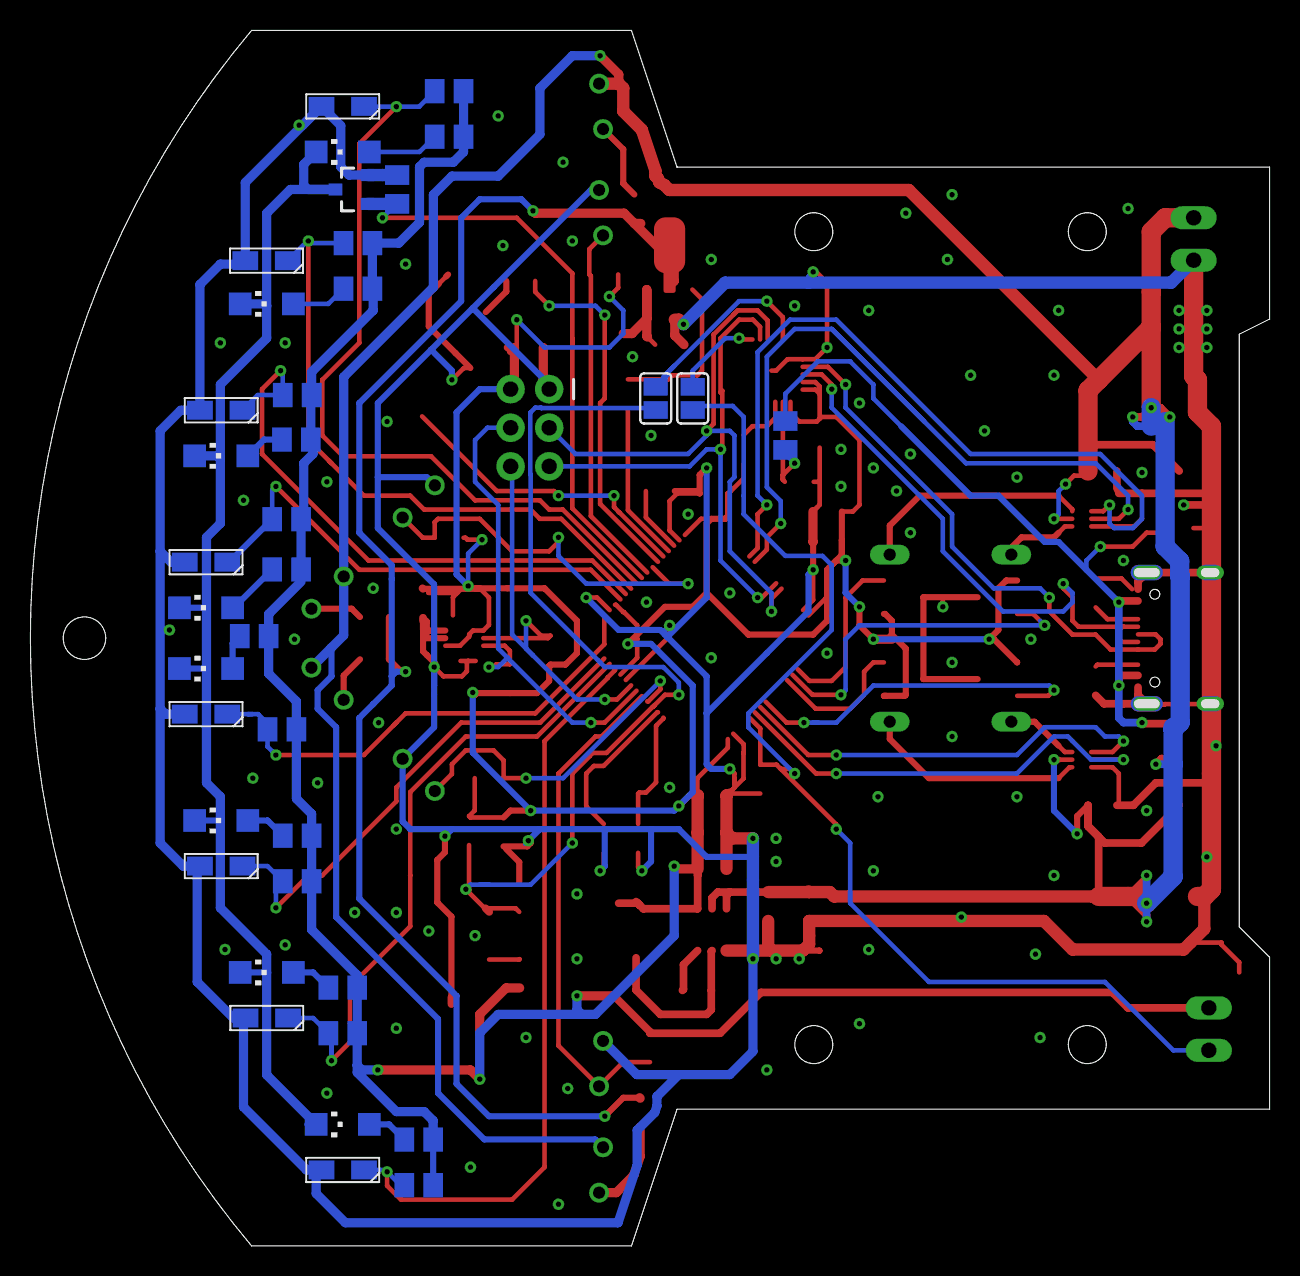
[picture p36: board motoko_ice_dragon_x_dc.brd from below]

Board: 2 copper layers, 81.6 x 80.0 mm, 119 parts (37 on the bottom side), 69 nets.
