michalnand/motoko_ice_dragon_x/hardware/encoder/encoder_gerber.brd

## EAGLE design hardware/encoder/encoder_gerber.brd (2024-11-22)

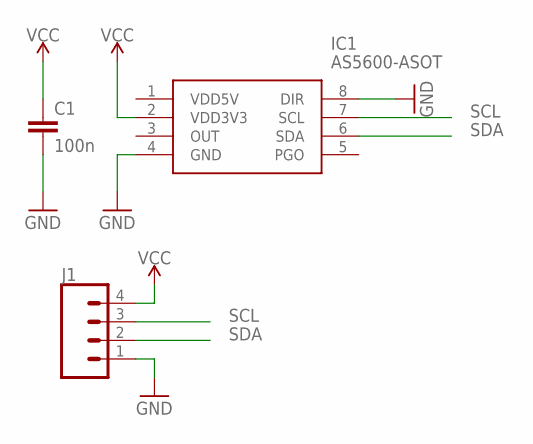
[picture p37: schematic encoder_gerber.sch]

Parts:
C1: 100n; C0805
IC1: AS5600-ASOT; SOIC127P600X175-8N
J1: CONN_04LONGPADS; 1X04_LONGPADS

Connections:
GND: C1.2, IC1.4 (GND), IC1.8 (DIR), J1.1
SCL: IC1.7 (SCL), J1.3
SDA: IC1.6 (SDA), J1.2
VCC: C1.1, IC1.2 (VDD3V3), J1.4

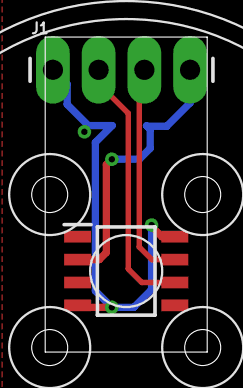
[picture p38: board encoder_gerber.brd from above]

Board: 2 copper layers, 9.0 x 17.5 mm, 4 parts (1 on the bottom side), 4 nets.

Other parts of the board:
U$1: BRUSHLESS_GIMBAL_MOTOR_2204
