michalnand/motoko_ice_dragon_x/firmware/LibsDrivers/libs_drivers.cpp

#include "libs_drivers.h"


// global drivers are instantianed here
Terminal    terminal;
Timer       timer;    

ADC_driver  adc;

LineSensor   line_sensor;
IRSensor     ir_sensor;


MotorControl motor_control;

void LibsDriversInit()
{
    // low level init, cache, clock
    drivers_init();  

    // uart initialisation
    uart_init();

    // terminal init
    terminal.init();

    // timer
    timer.init();

    adc.init();    
    line_sensor.init();
    ir_sensor.init();

    // motor control init
    motor_control.init();
}
