michalnand/motoko_ice_dragon_x/firmware_orig/demos/bldc_motor_test/main.cpp

#include <drivers.h>

#include <gonio.h>

int main()
{
    drivers_init();
  
    terminal << "\n\n\n"; 
    terminal << "machine ready\n";

    // wait for key press
    int key_result = button();

    terminal << "starting\n";

    
    /*
    float velocity[] = {0, 50, 100, 200, 500, 1000};

    uint32_t steps = 0;         
    while (true)    
    {
        uint32_t idx = (steps/100)%6;    

        float v = velocity[idx]*2.0*PI/60.0;      

        motor_control.set_left_velocity(v);
        motor_control.set_right_velocity(v);


        steps++;

        timer.delay_ms(20);

        terminal << motor_control.get_left_encoder() << " " << motor_control.get_right_encoder() << "\n";
    }
    */

    
    float torque[] = {0.0, 0.25, 0.5, 1.0};

    uint32_t steps = 0;         
    while (true)    
    {
        uint32_t idx = (steps/100)%4;    

        motor_control.set_left_torque(torque[idx]);
        motor_control.set_right_torque(torque[idx]);


        steps++;

        timer.delay_ms(20);

        terminal << motor_control.get_left_encoder() << " " << motor_control.get_right_encoder() << "\n";
    }
   

    return 0;
}
  
