michalnand/motoko_ice_dragon_x/firmware/demos/position_control/position_control.h

#ifndef _POSITION_CONTROL_H_
#define _POSITION_CONTROL_H_

#include <stdint.h>

#include "lqr.h"
#include "lqg.h"

// 4000us period = 250Hz loop
#define POSITION_CONTROL_DT     ((uint32_t)4000)

#define WHEEL_BRACE             ((float)78.0)
#define WHEEL_DIAMETER          ((float)28.0)


class PositionControl
{
    public:
        void init();
        void set_desired(float distance, float angle);

        float get_distance();
        float get_angle();

        float get_velocity();
        float get_angular_velocity();

        
    public:
        void callback();

    private:
        void timer_init();
    
    private:
        LQR<4, 2> controller;   
        //LQG<4, 2> controller;   

    public:
        float distance_prev;
        float distance;
        float angle_prev;
        float angle;

    public:
        uint32_t steps;
};


#endif
