michalnand/motoko_ice_dragon_x/firmware_orig/usr/tests.h

#ifndef _TESTS_H_
#define _TESTS_H_


void motors_test();
void gyro_sensor_test();
void gyro_stabilisation_test();

void ir_sensor_test();
void line_sensor_test();
void encoder_sensor_test();

void left_motor_connect_test();
void left_motor_pwm_test();

void right_motor_connect_test();
void right_motor_pwm_test();

void sensors_test();

void motor_driver_test();
void smooth_motor_driver_test();


void turn_test();
void forward_test();


void mcu_usage();

void noise_measurement();

#endif
