michalnand/motoko_ice_dragon_x/(commit log)

2024-06-15 initial + hw
    [dc_front.stl, motoko_ice_dragon_x_dc.brd, motoko_ice_dragon_x_dc.sch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]
2024-06-16 bldc version
    [motoko_ice_dragon_x_dc.brd, motoko_ice_dragon_x_dc.sch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]
2024-06-19 firmware tests
    [motoko_ice_dragon_x.stl, motoko_ice_dragon_x_dc.dxf]
2024-06-21 ir sensors
2024-06-23 encoder fix
    [motoko_ice_dragon_x_dc.brd, motoko_ice_dragon_x_dc.dxf, motoko_ice_dragon_x_dc.sch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]
2024-08-07 motor control, motor identification
2024-08-08 identification demo
    [dc_front.stl, motoko_ice_dragon_x.stl, motoko_ice_dragon_x_dc.dxf, motoko_ice_dragon_x_front.stl]
2024-08-15 better encoder
2024-09-15 pid example
2024-10-28 kalman filter for encoder
    [motoko_ice_dragon_x_bldc.brd, motoko_ice_dragon_x_bldc.sch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]
2024-10-29 motor test
2024-11-22 bldc test
    [encoder_gerber.brd, encoder_gerber.sch, magnet_holder.stl, motoko_ice_dragon_x.stl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]
2024-11-26 mpc simulation
    [whell_tire_form_b.stl]
2025-03-02 position control
    [motoko_ice_dragon_x_bldc.brd, motoko_ice_dragon_x_bldc.dxf, motoko_ice_dragon_x_bldc.sch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]
2025-03-13 new motor control
2025-03-23 mpc line following
    [dragon.stl, robot_box_a.stl, robot_box_b.stl]
2025-03-30 line following + broken line
    [LineFollowing.cpp, LineFollowing.h, QEstimator.h, main.cpp]
2025-11-20 cleaned up firmware, work in progress
    [dragon.stl, magnet_holder.stl, motoko_ice_dragon_x.stl, motoko_ice_dragon_x_bldc.brd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]
2025-11-21 add tests, motor driver, adc
2025-11-23 bldc sinusoidal control
2025-11-24 velocity control
    [robot.obj]
